majaczech/BDVP/README.md

# Robust Bi-Directional Velocity Probe with Arduino-based Measuring Unit
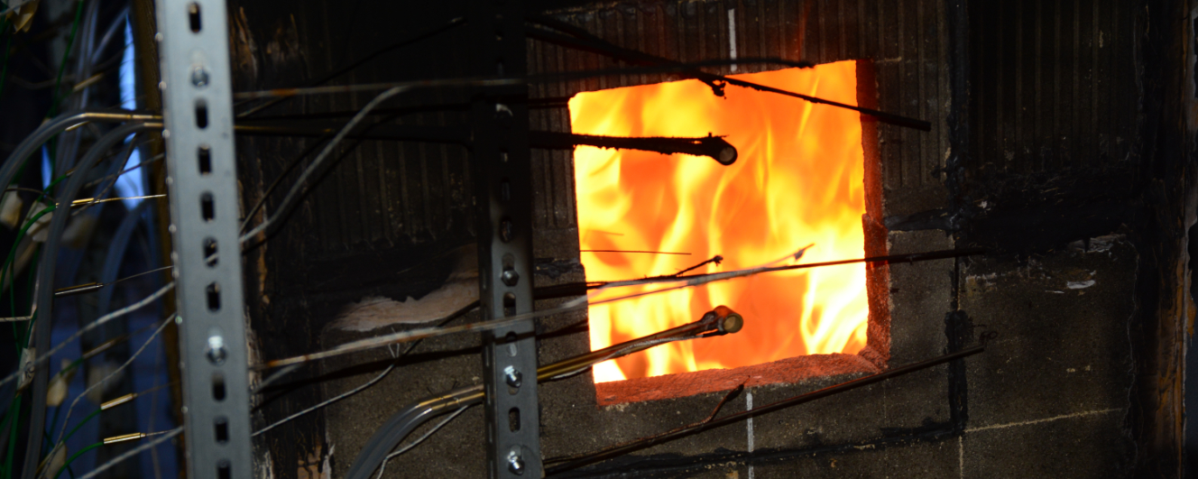
[picture p1: Images/PP-abstract.jpg]
BDVP


This project describes manufacturing of robust bi-directional velocity probes (BDVP) and building measuring unit for fire engineering application.

This source describes Open Hardware and is licensed under the CERN-OHL-S v2

**Experience with manufacturing, hot-works, using angle grinder, drill and autogenous welder is mandatory!
Also, experience with Arduino platform is required and supervision from a qualified electric engineering professional.**

**The project is prototype under development and authors are not responsible for any damages or injuries caused by inappropriate construction or operation.**
**This source is distributed WITHOUT ANY EXPRESS OR IMPLIED WARRANTY, INCLUDING OF MERCHANTABILITY, SATISFACTORY QUALITY AND FITNESS FOR A PARTICULAR PURPOSE.**

# References
1. McCafferey, B. J., Heskestad, G., “A Robust Bidirectional Low-Velocity Probe for Flame and Fire Application,” Combustion and Flame, Vol. 26, 1976, pp. 125-127 
2. Liu, C. Y., Wong, Y. W., Chan, W. K., & Can, T. C. (1990). Note on the robust bidirectional low velocity probe. Experiments in Fluids, 9(6), 354–356. https://doi.org/10.1007/bf00188768 
3. Kent, L A, and Schneider, M E. The design and application of bi-directional velocity probes for measurements in large pool fires. United States: N. p., 1987. Web.
4. Sung Chan Kim, Jung Yong Kim, The Effect of Flow Approaching Angle on the Velocity Measurement Using Bi-directional Velocity Probe, Procedia Engineering, Volume 62, 2013, Pages 797-803, ISSN 1877-7058, https://doi.org/10.1016/j.proeng.2013.08.128.
