majaczech/BDVP/Images/application-2.jpg

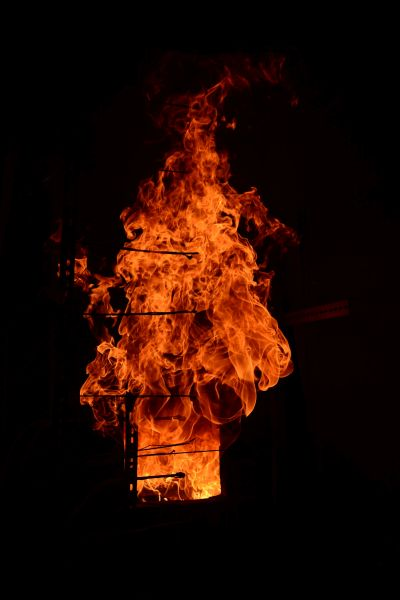
Images/application-2.jpg
