majaczech/BDVP/Images/Final-BDVP.jpg

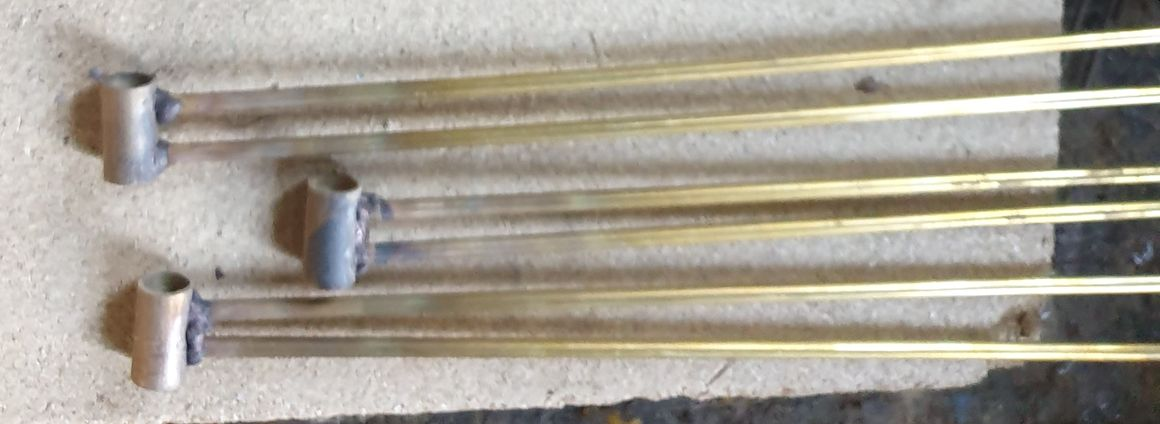
Images/Final-BDVP.jpg
