majaczech/BDVP/Images/Scheme-BDVP.jpg

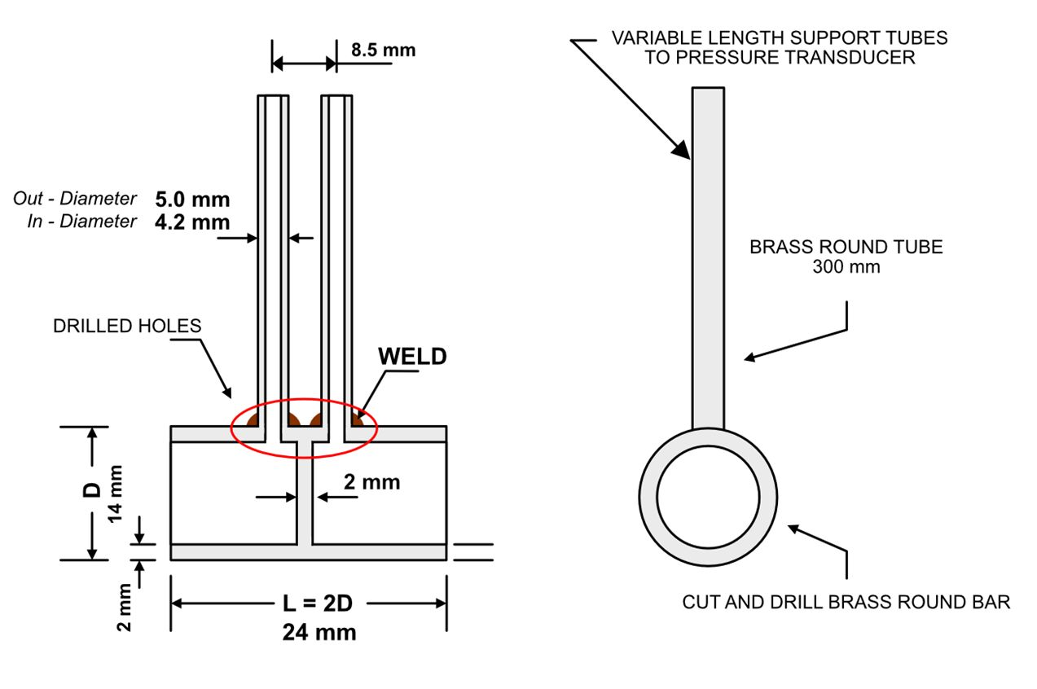
Images/Scheme-BDVP.jpg
