majaczech/BDVP/Images/Welding.jpg

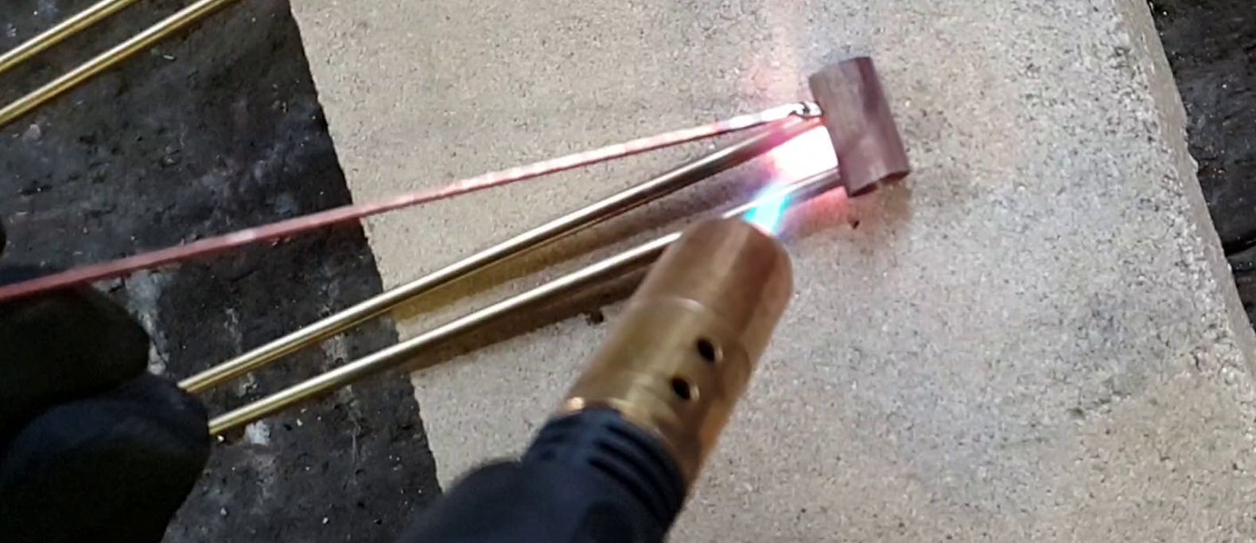
Images/Welding.jpg
