majaczech/BDVP/BOM/BOM.xlsx

Sheet: BOM
Designator | Component | Number | Cost per unit | Total cost [€] | Source of materials | Material type | WWW
 |  |  | [€]
Pressure probe
Suppor of pressure probe | Brass round tube d = 5 / 4.2 mm x 1000 mm | 1 | 3.34 | 3.34 | Peckamodel | Metal | https://www.peckamodel.cz/2225647-mosazna-trubka-prumer-5-0-4-2-mm
Head of pressure probe | Brass round bar 14 x 1000 mm | 1 | 16.93 | 16.93 | Kutil | Metal | https://www.kutil.cz/zelezarstvi/hutni-material/mosazny/tyc-kruhova-mosaz-14mm/
Connectection | Silicone Tubing, 5mm ID x 8mm OD 1.5m Rubber Tube Air Hose Water Pipe for Pump Transfer, Semi Clear | 1 | 7.53 | 7.53 | Amazon | Silicone tube | https://www.amazon.co.uk/sourcing-map-Silicone-Tubing-Transfer/dp/B085N1ZTWK?currency=EUR
Measuring Unit
Arduino UNO | Arduino Uno | 1 | 20 | 20 | Arduino | Electronics | https://store.arduino.cc/arduino-uno-rev3
Pressure Transducer | SETRA C264+/-0.25 PRESSURE TRANSDUCER RANGE 0-0.25" WC EXITATION 24 VDC 4-20 MA | 1 | 55.99 | 55.99 | Ebay | Pressure transducer | https://www.ebay.com/itm/SETRA-C264-0-25-PRESSURE-TRANSDUCER-RANGE-0-0-25-WC-EXITATION-24-VDC-4-20-MA-/361753382870
Analog-Digital Convertor | ADS1115 16-Bit ADC - 4 Channel with Programmable Gain Amplifier | 1 | 12.31 | 12.31 | Adafruit | Electronics | https://www.adafruit.com/product/1085
Resistor | Resistor 100 Ohm | 1 | 0.19 | 0.19 | Ampul | Electronics | https://www.ampul.eu/cs/metalizovane-rezistory/3922-532-rezistor-2w-1-dratovy
Resistor | Resistor 150 Ohm | 1 | 0.19 | 0.19 | Ampul | Electronics | https://www.ampul.eu/cs/metalizovane-rezistory/3922-532-rezistor-2w-1-dratovy
Jumper | Premium Female/Female Jumper Wires - 20 x 6" (150mm) | 1 | 1.61 | 1.61 | Adafruit | Wires | https://www.adafruit.com/product/1950
Jumper | Premium Male/Male Jumper Wires - 20 x 6" (150mm | 1 | 1.61 | 1.61 | Adafruit | Wires | https://www.adafruit.com/product/1957
Jumper | Premium Female/Female Jumper Wires - 20 x 6" (150mm) | 1 | 1.61 | 1.61 | Adafruit | Wires | https://www.adafruit.com/product/1950
Wires | YV Gear Wire Assortment, 0.50 mm, copper Tinned, 2x 25 m Reel Red/Black | 1 | 7.95 | 7.95 | Amazon | Wires | https://www.amazon.de/-/en/Assortment-0-50-copper-Tinned-Black/dp/B01CME8WPG?s=diy
Breadboard | BB830 Solderless Plug-in BreadBoard, 830 tie-Points, 4 Power Rails, 6.5 x 2.2 x 0.3in (165 x 55 x 9mm) | 1 | 6.74 | 6.74 | Amazon | Electronics | https://www.amazon.com/BB830-Solderless-Plug-BreadBoard-tie-Points/dp/B0040Z4QN8?currency=EUR&language=en_US
 |  |  | Sum | 136 | €

Sheet: Design Files Summary
Design file name | File type | Open source license | Location of the file
Assembly diagram | Figure (JPG) | CC BY-NC
Basic connection diagram | Figure (JPG) | CC BY-NC
Advanced connection diagram | Figure (JPG) | CC BY-NC
