majaczech/BDVP/Images/Manufacturing-1.jpg

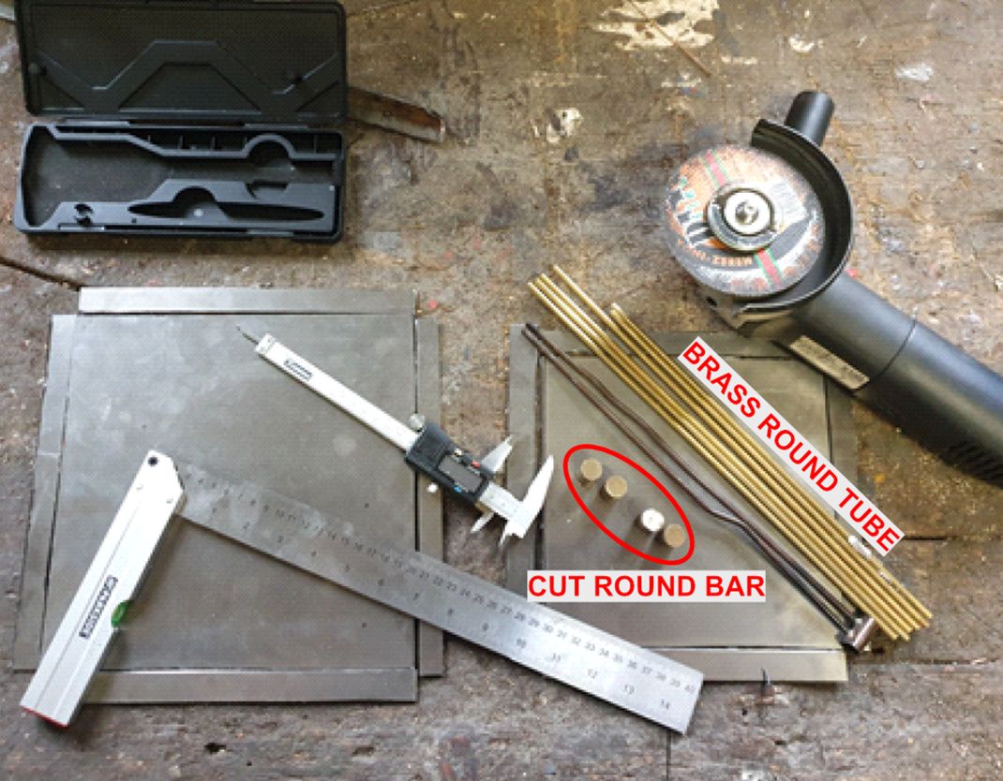
Images/Manufacturing-1.jpg
