majaczech/BDVP/Wiring/Multiple-connection-wiring.jpg

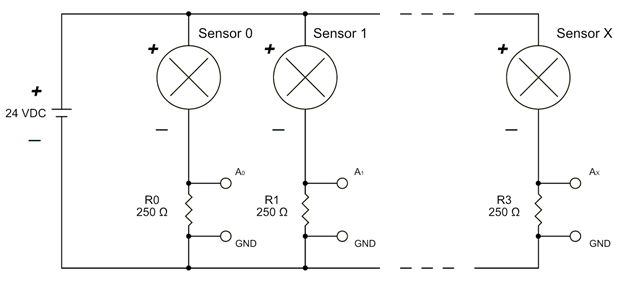
Wiring/Multiple-connection-wiring.jpg
