majaczech/BDVP/Wiring/Multiple-connection.jpg

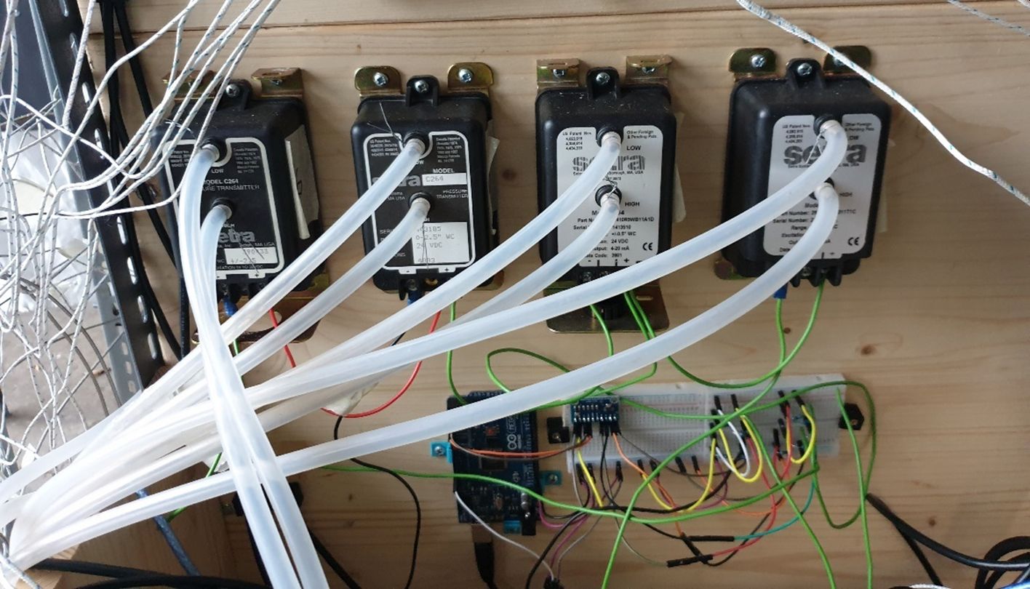
Wiring/Multiple-connection.jpg
