majaczech/BDVP/Wiring/Wiring-1ch-no-ADC.jpg

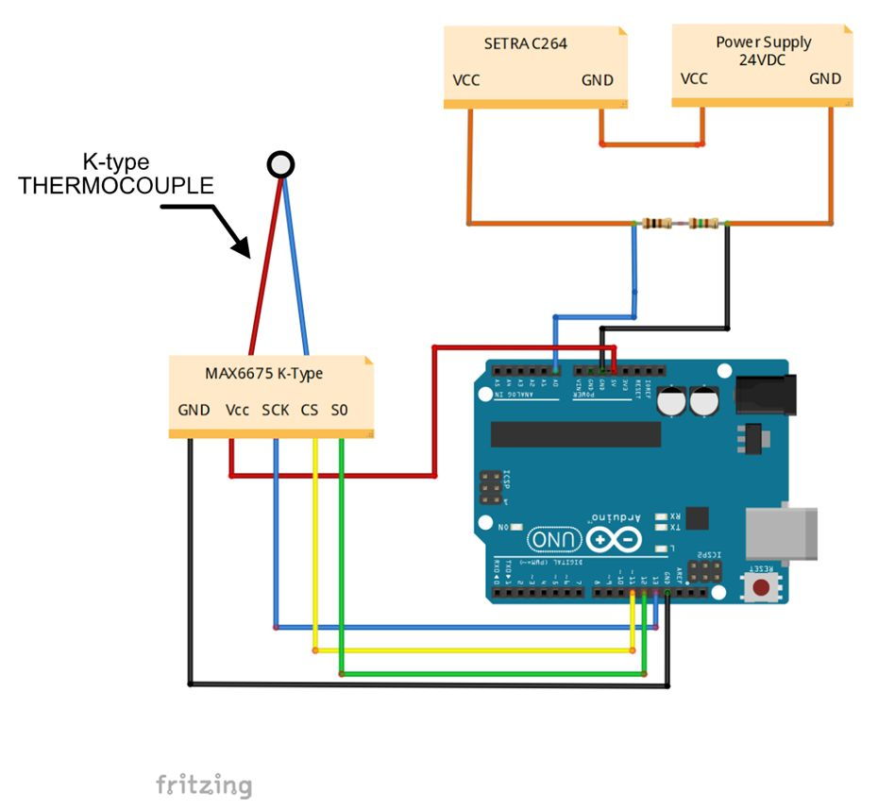
Wiring/Wiring-1ch-no-ADC.jpg
