majaczech/BDVP/Wiring/Wiring-current-converter-1ch.jpg

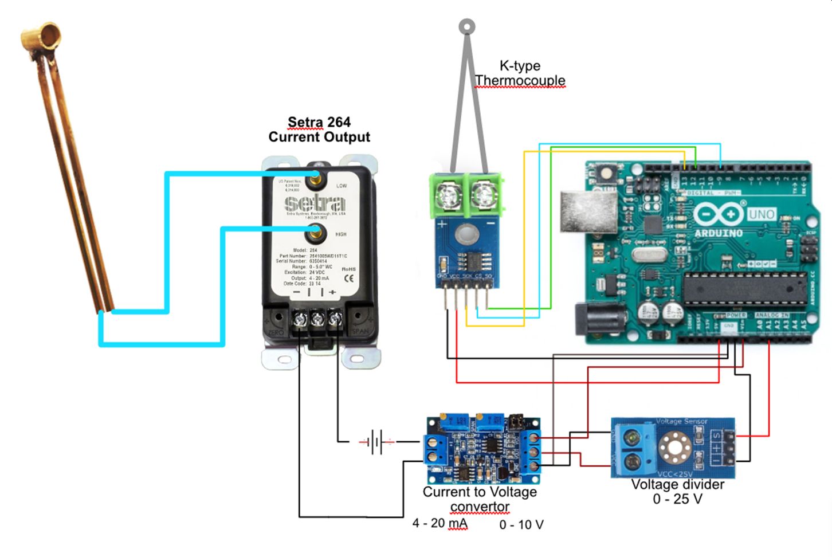
Wiring/Wiring-current-converter-1ch.jpg
