majaczech/BDVP/Wiring/Wiring-multi-ch-ADC.jpg

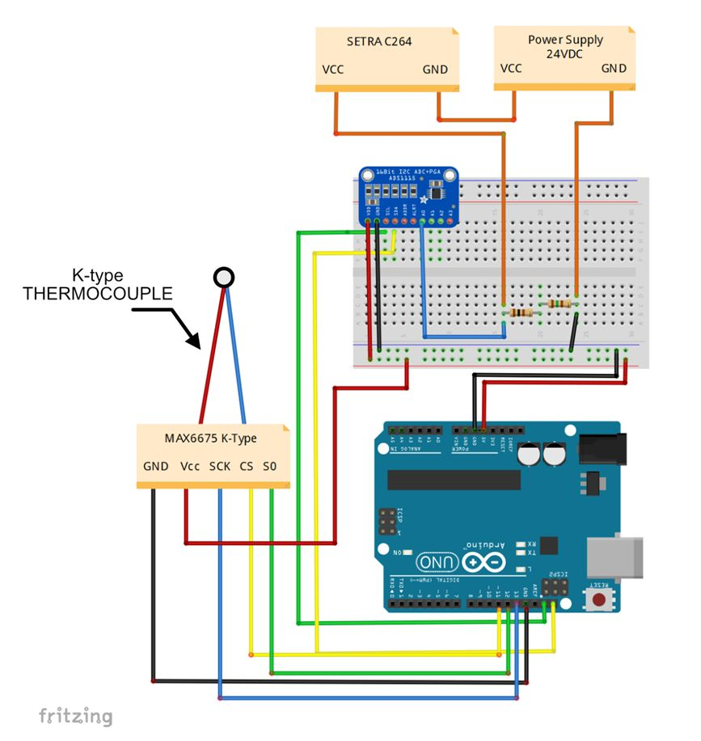
Wiring/Wiring-multi-ch-ADC.jpg
